kd4gar/kegerator-gauge/esp32_gauge_wiring.png

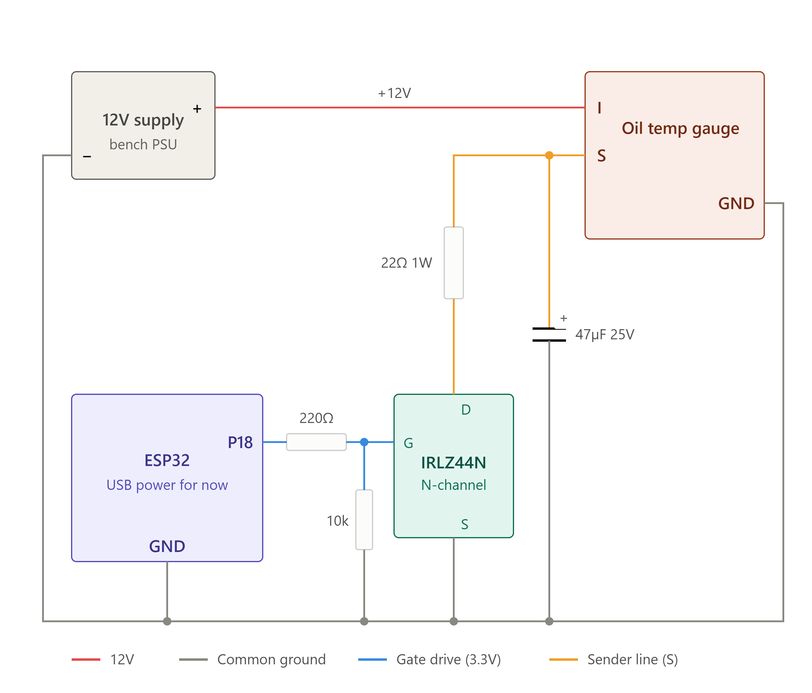
esp32_gauge_wiring.png
