kd4gar/kegerator-gauge/(commit log)

2026-10-02 Initial commit: ESP32 kegerator CO2 pressure gauge
    Drives a 12V automotive gauge from an ESP32 (PWM + MOSFET sender
    emulation) and reads a 0-60 psi transducer. Joins home Wi-Fi with a
    fallback setup network, serves a display page and a password-protected
    config page at kegerator.local, and supports OTA updates via
    ota-upload.bat.
2026-10-02 Add DS18B20 temperature probes to wiring diagram
    Two probes (keg and fridge air) share one 1-Wire bus on GPIO4,
    powered from 3V3, with a single 4.7k pull-up from data to 3V3.
2026-10-03 Add DS18B20 keg/air temperature probes and installation harness
    - Read two DS18B20 probes on one 1-Wire bus (GPIO4) every 2 s without
    blocking; discard -127 / 85 C error values and rescan for missing probes
    - Assign probes to keg / air by ID on /config (saved in flash); display
    page shows "not assigned" / "probe offline" states; new `t` command
    - Fix probe scan: DallasTemperature::setResolution() without
    skipGlobal=true runs its own search and corrupted ours
    - Add cable-plan.svg: 9-wire color-coded harness from the box on top of
    the fridge through the side wall
    - Wiring diagram: gauge lamp now 5V LED; 47uF stays in the box
    - README: probes, harness, installation notes, required libra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
    [PhysicalGauge.ino]
2026-10-04 Add /api endpoint with pressure and temperatures as JSON
    GET /api returns {"psi":..,"kegF":..,"airF":..} for other programs
    (e.g. a C# client). Values are null when there is no valid reading.
    Kept separate from /data so it stays stable as the web pages change.
2026-10-04 Display page: never show negative pressure
    Clamp the pressure readout and needle on the display page at 0 psi.
    The config page and /api still report the raw value for calibration
    and for clients that handle it themselves.
